X-Microsystems/xmicro-bp8/README.md

# XMICRO-BP8

Eight-slot [XMICRO](https://github.com/x-microsystems/xmicro-bus) backplane.

Datasheet: [XMICRO-BP8](Documentation/XMICRO-BP8.pdf)

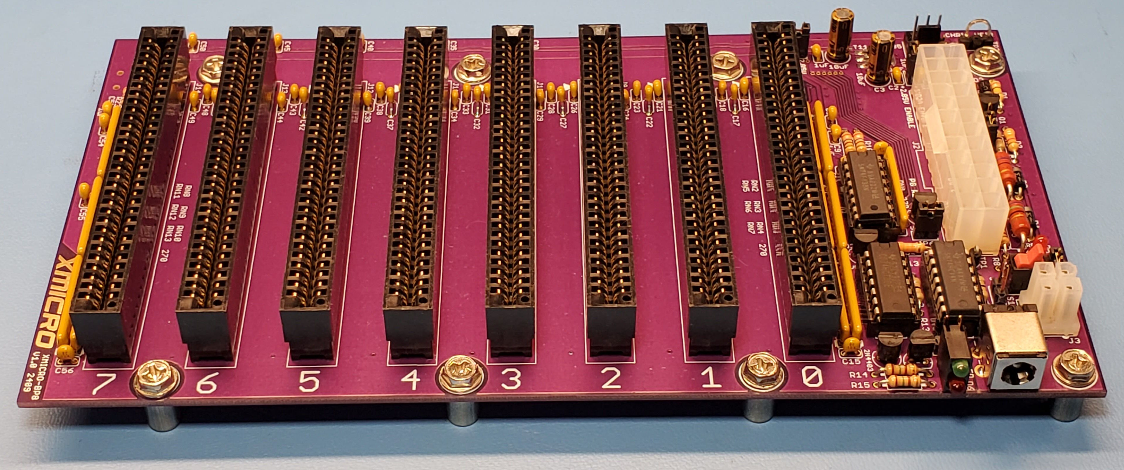
[picture p1: Images/XMICRO-BP8 1.jpg]
XMICRO-BP8
