X-Microsystems/xmicro-bp8/Hardware/Gerbers/README.txt

XMICRO-BP8 is designed for 2oz copper PCBs. Standard 1oz plating will work, but any voltage/current specifications will be invalid and must be derated.
