X-Microsystems/xmicro-bp8/Documentation/Schematics/Netlist.txt

Netlist

Exported from XMICRO-BP8 V1.0.sch at 2024-09-15 12:36:48

EAGLE Version 6.3.0 Copyright (c) 1988-2012 CadSoft

Net      Part     Pad      Pin        Sheet

!BUSAK   J10      12       !BUSAK     1
         J11      12       !BUSAK     1
         J12      12       !BUSAK     1
         J13      12       !BUSAK     1
         J14      12       !BUSAK     1
         J7       12       !BUSAK     1
         J8       12       !BUSAK     1
         J9       12       !BUSAK     1
         RN5      2        2          3
         RN8      2        2          3

!BUSRQ   J10      11       !BUSRQ     1
         J11      11       !BUSRQ     1
         J12      11       !BUSRQ     1
         J13      11       !BUSRQ     1
         J14      11       !BUSRQ     1
         J7       11       !BUSRQ     1
         J8       11       !BUSRQ     1
         J9       11       !BUSRQ     1
         RN11     2        2          3
         RN2      2        2          3

!CS0     J7       9        !CSX       1
         R10      1        1          3
         RN1      3        3          3
         U3       15       Y0         4

!CS1     J8       9        !CSX       1
         R16      1        1          3
         RN1      4        4          3
         U3       14       Y1         4

!CS2     J9       9        !CSX       1
         R17      1        1          3
         RN1      5        5          3
         U3       13       Y2         4

!CS3     J10      9        !CSX       1
         R18      1        1          3
         RN1      6        6          3
         U3       12       Y3         4

!CS4     J11      9        !CSX       1
         R19      1        1          3
         RN1      7        7          3
         U3       11       Y4         4

!CS5     J12      9        !CSX       1
         R20      1        1          3
         RN1      8        8          3
         U3       10       Y5         4

!CS6     J13      9        !CSX       1
         R21      1        1          3
         RN1      9        9          3
         U3       9        Y6         4

!CS7     J14      9        !CSX       1
         R22      1        1          3
         RN1      2        2          3
         U3       7        Y7         4

!FETCH   J10      14       !FETCH     1
         J11      14       !FETCH     1
         J12      14       !FETCH     1
         J13      14       !FETCH     1
         J14      14       !FETCH     1
         J7       14       !FETCH     1
         J8       14       !FETCH     1
         J9       14       !FETCH     1
         RN5      3        3          3
         RN8      3        3          3

!HALT    J10      15       !HALT      1
         J11      15       !HALT      1
         J12      15       !HALT      1
         J13      15       !HALT      1
         J14      15       !HALT      1
         J7       15       !HALT      1
         J8       15       !HALT      1
         J9       15       !HALT      1
         RN11     4        4          3
         RN2      4        4          3

!INH     J10      17       !INH       1
         J11      17       !INH       1
         J12      17       !INH       1
         J13      17       !INH       1
         J14      17       !INH       1
         J7       17       !INH       1
         J8       17       !INH       1
         J9       17       !INH       1
         RN11     5        5          3
         RN2      5        5          3

!IOSEL   J10      18       !IOSEL     1
         J11      18       !IOSEL     1
         J12      18       !IOSEL     1
         J13      18       !IOSEL     1
         J14      18       !IOSEL     1
         J7       18       !IOSEL     1
         J8       18       !IOSEL     1
         J9       18       !IOSEL     1
         RN5      5        5          3
         RN8      5        5          3
         U3       4        G2A        4

!NMI     J10      61       !NMI       1
         J11      61       !NMI       1
         J12      61       !NMI       1
         J13      61       !NMI       1
         J14      61       !NMI       1
         J7       61       !NMI       1
         J8       61       !NMI       1
         J9       61       !NMI       1
         RN13     2        2          3
         RN4      2        2          3

!RD      J10      19       !RD        1
         J11      19       !RD        1
         J12      19       !RD        1
         J13      19       !RD        1
         J14      19       !RD        1
         J7       19       !RD        1
         J8       19       !RD        1
         J9       19       !RD        1
         RN11     6        6          3
         RN2      6        6          3

!RST     J10      10       !RST       1
         J11      10       !RST       1
         J12      10       !RST       1
         J13      10       !RST       1
         J14      10       !RST       1
         J7       10       !RST       1
         J8       10       !RST       1
         J9       10       !RST       1
         JP6      2        2          2
         R11      2        2          3
         R12      1        1          2
         R23      2        2          3

!SINT    J10      51       !SINT      1
         J11      51       !SINT      1
         J12      51       !SINT      1
         J13      51       !SINT      1
         J14      51       !SINT      1
         J7       51       !SINT      1
         J8       51       !SINT      1
         J9       51       !SINT      1
         Q3       3        D          4
         RN10     6        6          3
         RN7      6        6          3

!V0      J10      53       !V0        1
         J11      53       !V0        1
         J12      53       !V0        1
         J13      53       !V0        1
         J14      53       !V0        1
         J7       52       !IRQX      1
         J7       53       !V0        1
         J8       53       !V0        1
         J9       53       !V0        1
         RN13     6        6          3
         RN4      6        6          3
         U4       1        I0         4

!V1      J10      54       !V1        1
         J11      54       !V1        1
         J12      54       !V1        1
         J13      54       !V1        1
         J14      54       !V1        1
         J7       54       !V1        1
         J8       52       !IRQX      1
         J8       54       !V1        1
         J9       54       !V1        1
         RN10     5        5          3
         RN7      5        5          3
         U4       2        I1         4

!V2      J10      55       !V2        1
         J11      55       !V2        1
         J12      55       !V2        1
         J13      55       !V2        1
         J14      55       !V2        1
         J7       55       !V2        1
         J8       55       !V2        1
         J9       52       !IRQX      1
         J9       55       !V2        1
         RN13     5        5          3
         RN4      5        5          3
         U4       3        I2         4

!V3      J10      52       !IRQX      1
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
         RN3      1        1          3
         RN4      1        1          3
         RN5      1        1          3
         RN6      1        1          3
         RN7      1        1          3
         RN8      1        1          3
         RN9      1        1          3
