X-Microsystems/xmicro-bp8/Documentation/XMICRO-BP8.odt

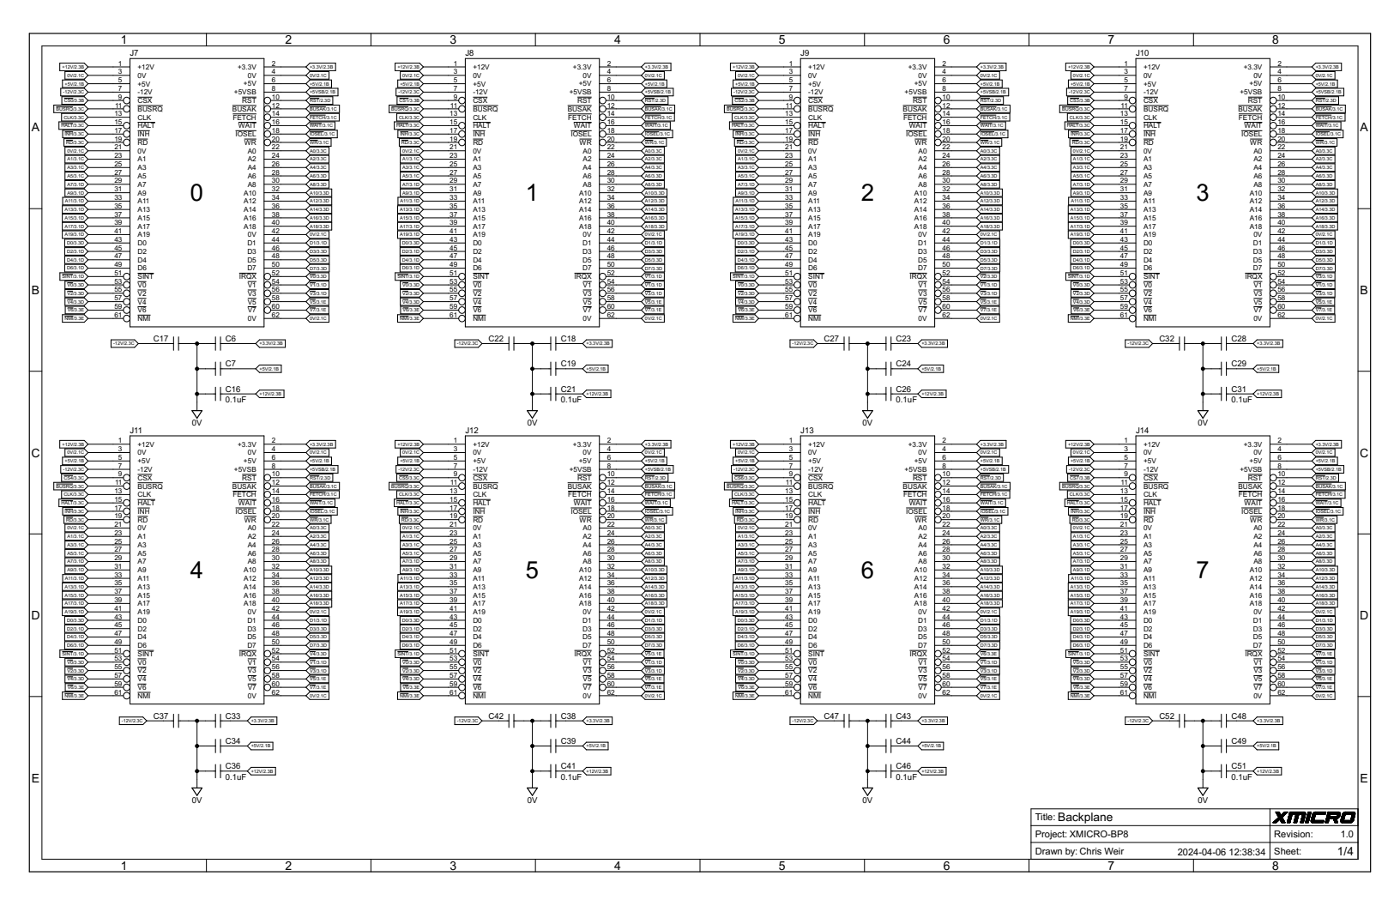
[picture p2: figure]
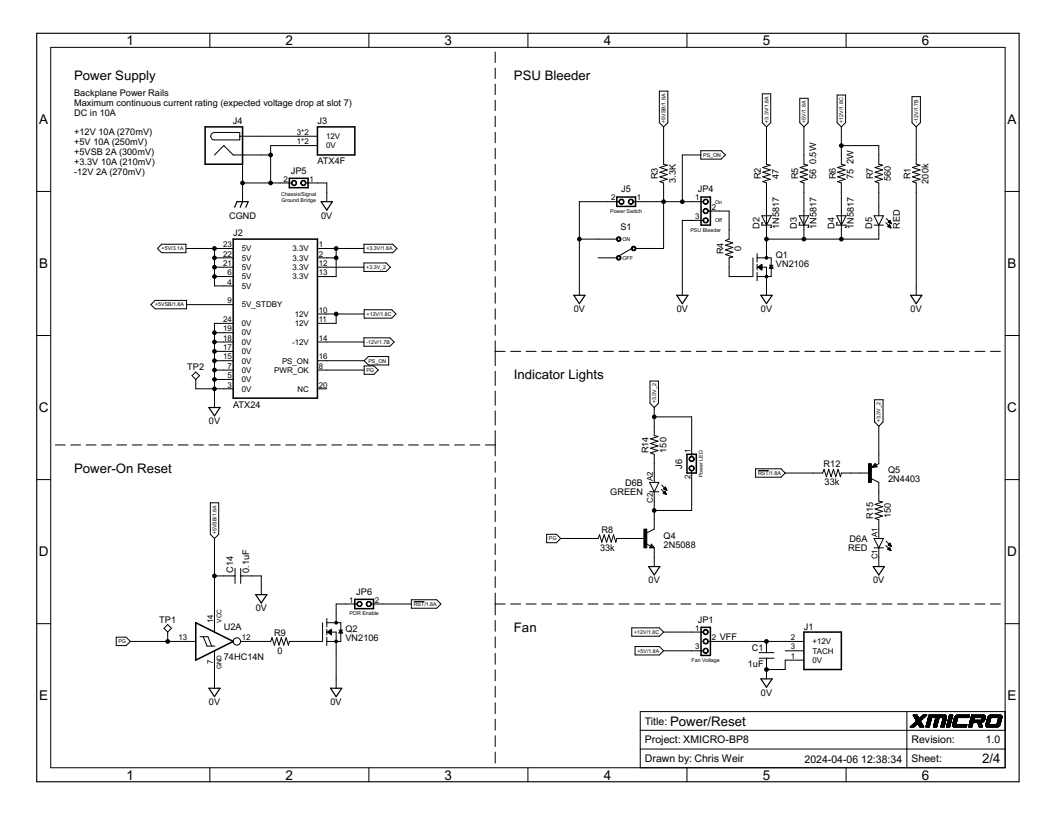
[picture p3: figure]
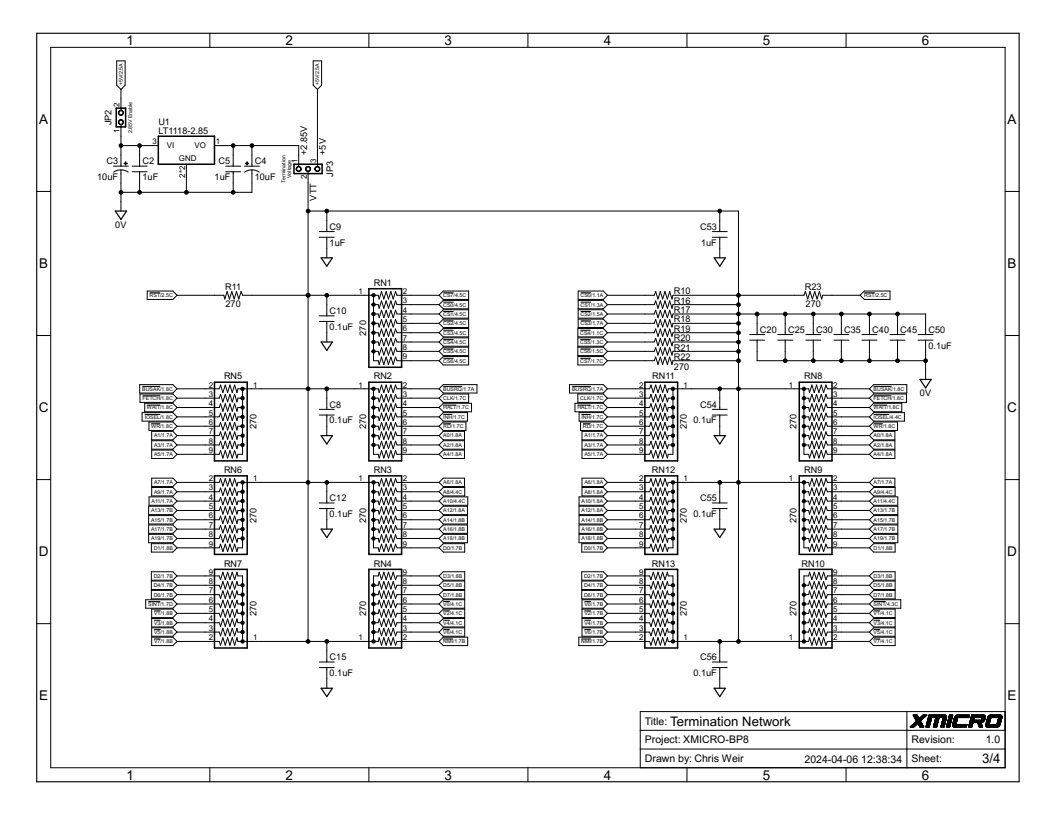
[picture p4: figure]
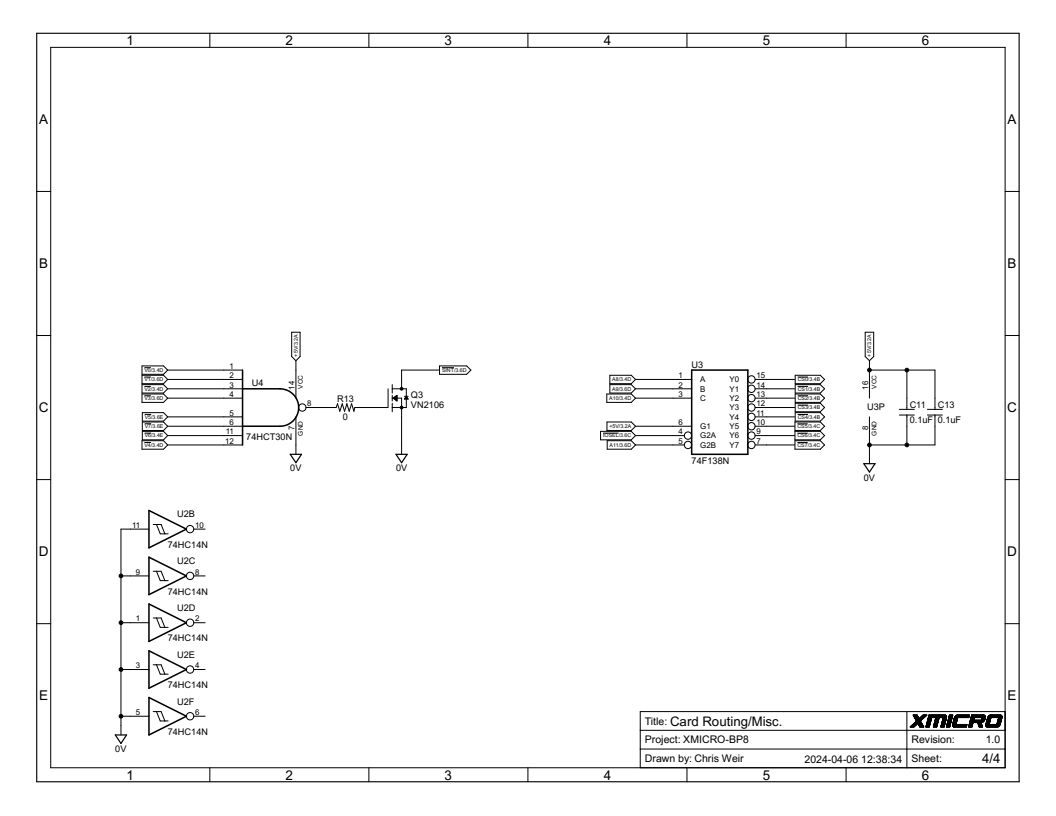
[picture p5: figure]

# General Description

The XMICRO-BP8 is an eight-slot XMICRO backplane with an ATX-compatible power input.

## Features

- 8 card slots
- Compatible with standard ATX power supplies
- DC power input for Pico ATX power supplies
- Active signal termination

## System Outline

Table 1: DC Specifications

Rail | Max. Current Total | Max. Current per card | Max. Current Per Contact | Slot 7 Voltage Drop @ Max. I
+12V | 10.0 A | 2.0 A | 2.0 A | 270 mV
+5V | 10.0 A | 4.0 A | 2.0 A | 250 mV
+5VSB | 2.0 A | 1.0 A | 1.0 A | 300 mV
+3.3V | 10.0 A | 2.0 A | 2.0 A | 210 mV
-12V | 2.0 A | 1.0 A | 1.0 A | 270 mV
DC IN | 10.0 A | - | - | -
*All current ratings continuous

Table 2: Backplane Configuration

Setting | Function
JP1 | Fan voltage select
JP2 | +2.85V termination regulator enable
JP3 | Bus termination voltage select
JP4 | PSU power-off bleeder enable/disable
JP5 | Bridge chassis/signal ground
JP6 | Power-on reset enable

# Power Supply

## PSU Selection

The backplane accepts standard ATX power supplies. Because of the relatively low power requirements of XMICRO systems, virtually any PC power supply will have suitable power delivery specifications.

The XMICRO-BP8 was designed to accept “Pico” style PSU-on-connector modules. A center-positive barrel jack (J4) is provided at the rear of the board to supply these modules with DC input power. This input is routed to a 4-pin Molex Mini-Fit Jr. connector (J3) with the standard ATX CPU pinout.

The PicoPSU-160-XT is recommended and directly compatible with the DC input jack.

## Grounding

When the DC input jack is not used, such as with full-sized ATX power supplies, jumper JP5 should be shorted. This connects the system chassis to the PSU ground to provide a return path for stray ESD/EMF.

## PSU Bleeder

During development, some PSUs, particularly Pico-style PSUs, were found to have excessive power-down times if certain rails are unloaded. A PSU bleeder circuit was added to the backplane to drain residual charge from the power rails, and to make the power-down faster and more stable.

The operation of this circuit is selected by jumper JP4, which must be set to ensure proper operation. For most ATX supplies, JP4 may be set to the OFF position. If power-down time is found to be excessive, JP4 may be set to the ON position, provided the power-down time is improved. This can be roughly visibly gauged by the Reset indicator fading slowly during power-down.

LED D5 indicates that the bleeder is active. It should only flash briefly when the power is switched off. If D5 is illuminated while the system is powered on, this indicates a fault in the circuit and JP4 should be confirmed. While the bleeder was designed to be capable of continuous operation in case of faults, it will generate excessive heat and should not be allowed to operate in this way.

# Signal Termination

The XMICRO-BP8 contains a termination network for all bus signal lines. This pulls all signals to +2.85V through a 270Ω resistor at each end of the backplane. This pulls signal lines to a known high state when not driven, and reduces ringing on fast signal edges. The termination network provides a significant load on signals, and as such cards must have drivers capable of sourcing/sinking at least 20mA per signal when it is fitted.

The termination network was designed with some flexibility for experimentation and troubleshooting, however in typical operation JP2 should be closed and JP3 should be set to “2.85V”.

# Off-board Components

## Power Switch

The backplane is fitted with an onboard power switch (S1) for development or operation without a chassis. An external power switch may be connected at header J5. When an external switch is used, S1 must be set in the OFF position.

## Power Indicator

A power indicator LED is provided on the rear of the backplane. An additional header (J6) is available for an external LED if desired. This connector provides a low-impedance 3.3V when the system power is on, so an appropriate current-limiting resistor should be fitted to any LED connected to it.

## Fan

A fan header (J1) is available for optional active cooling. Jumper JP1 selects a fan voltage and may be set to +5V for low noise, or +12V for full speed. An external fan controller may also be used on +12V.
