X-Microsystems/xmicro-bp8/Images/XMICRO-BP8 2.jpg

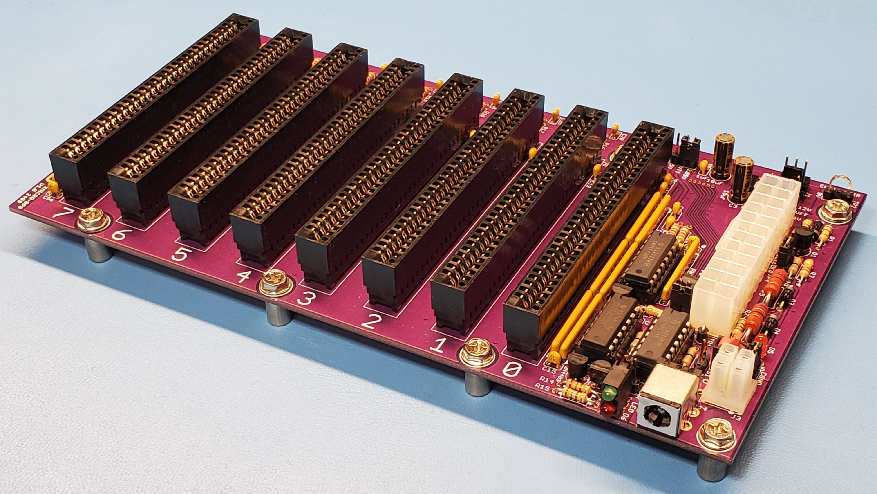
Images/XMICRO-BP8 2.jpg
