X-Microsystems/xmicro-bp8/Documentation/Schematics/XMICRO-BP8 V1.0 Color.pdf

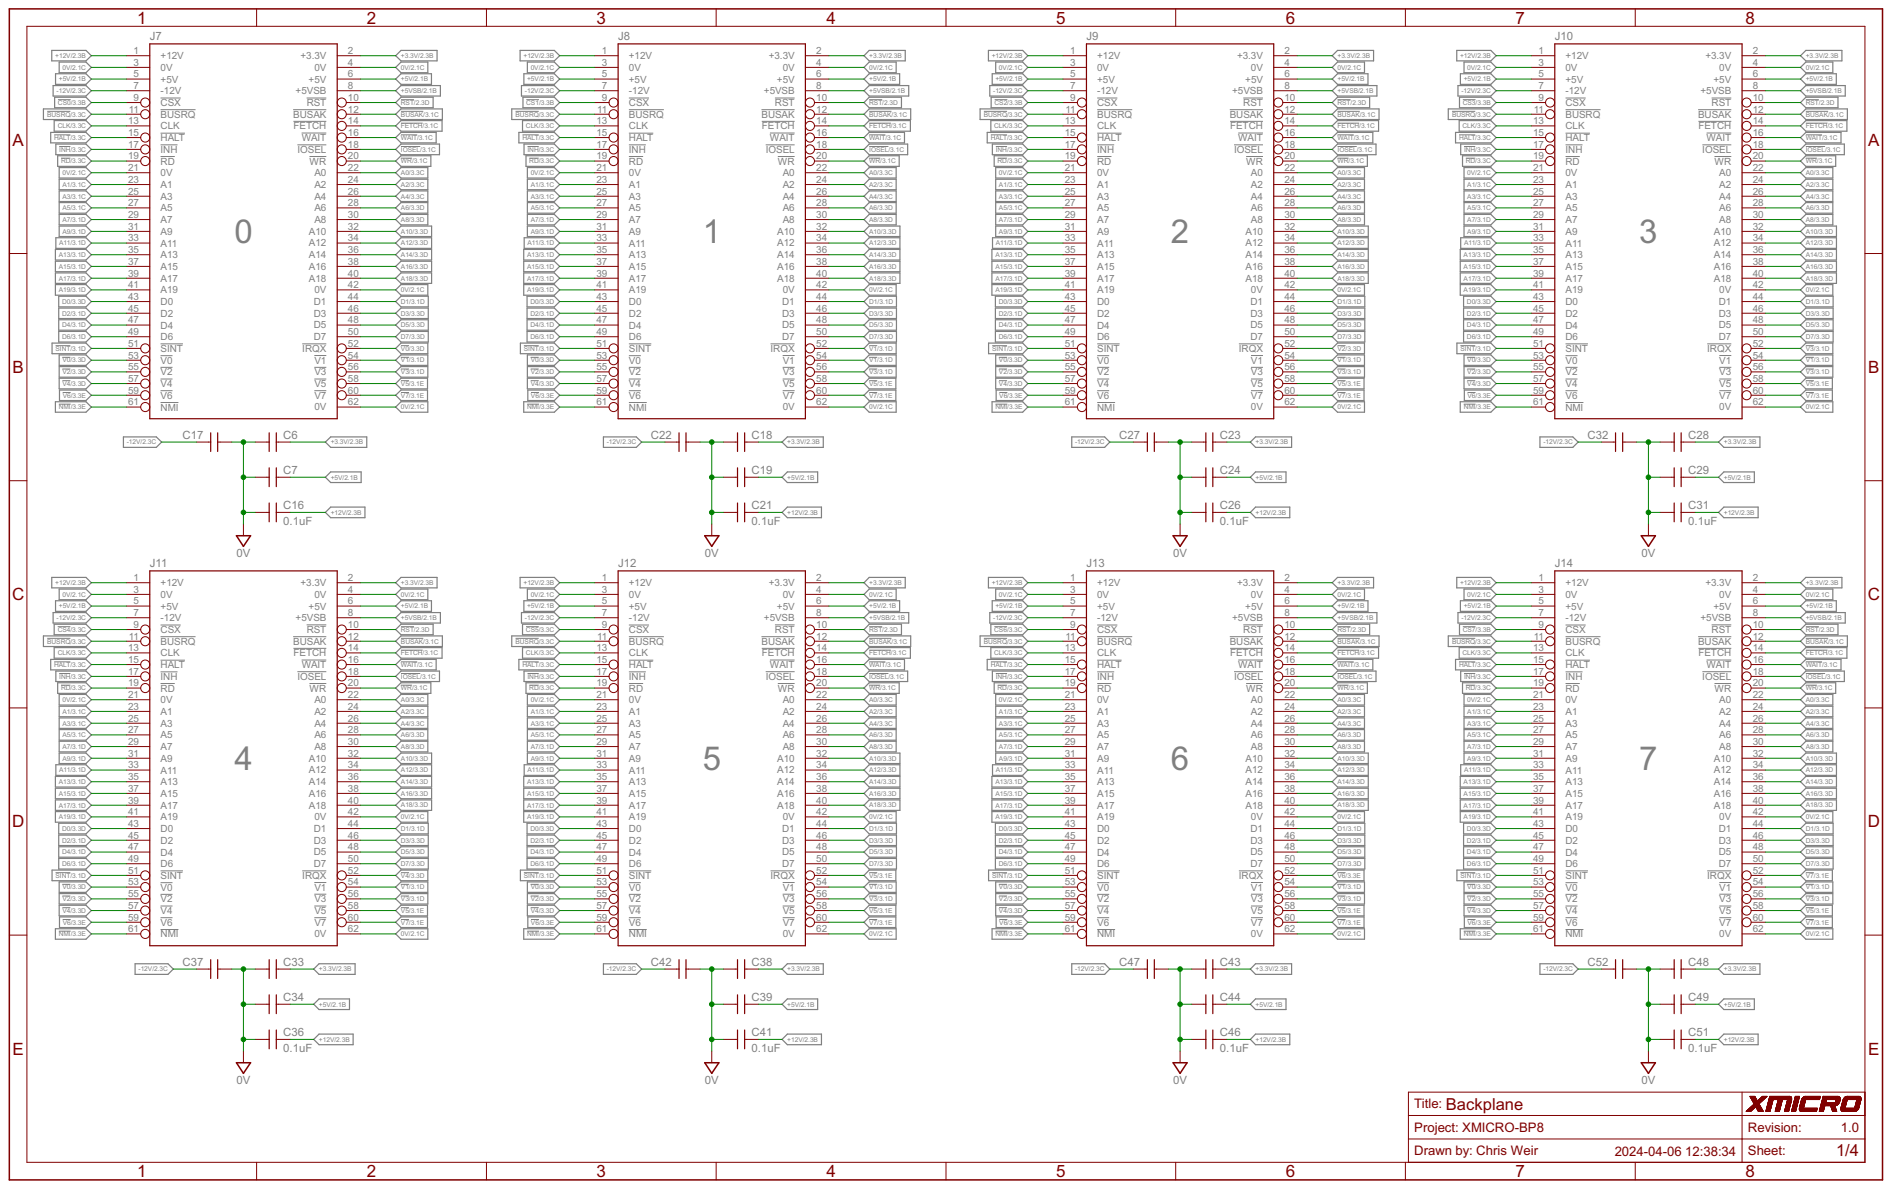
[picture p11: page 1]

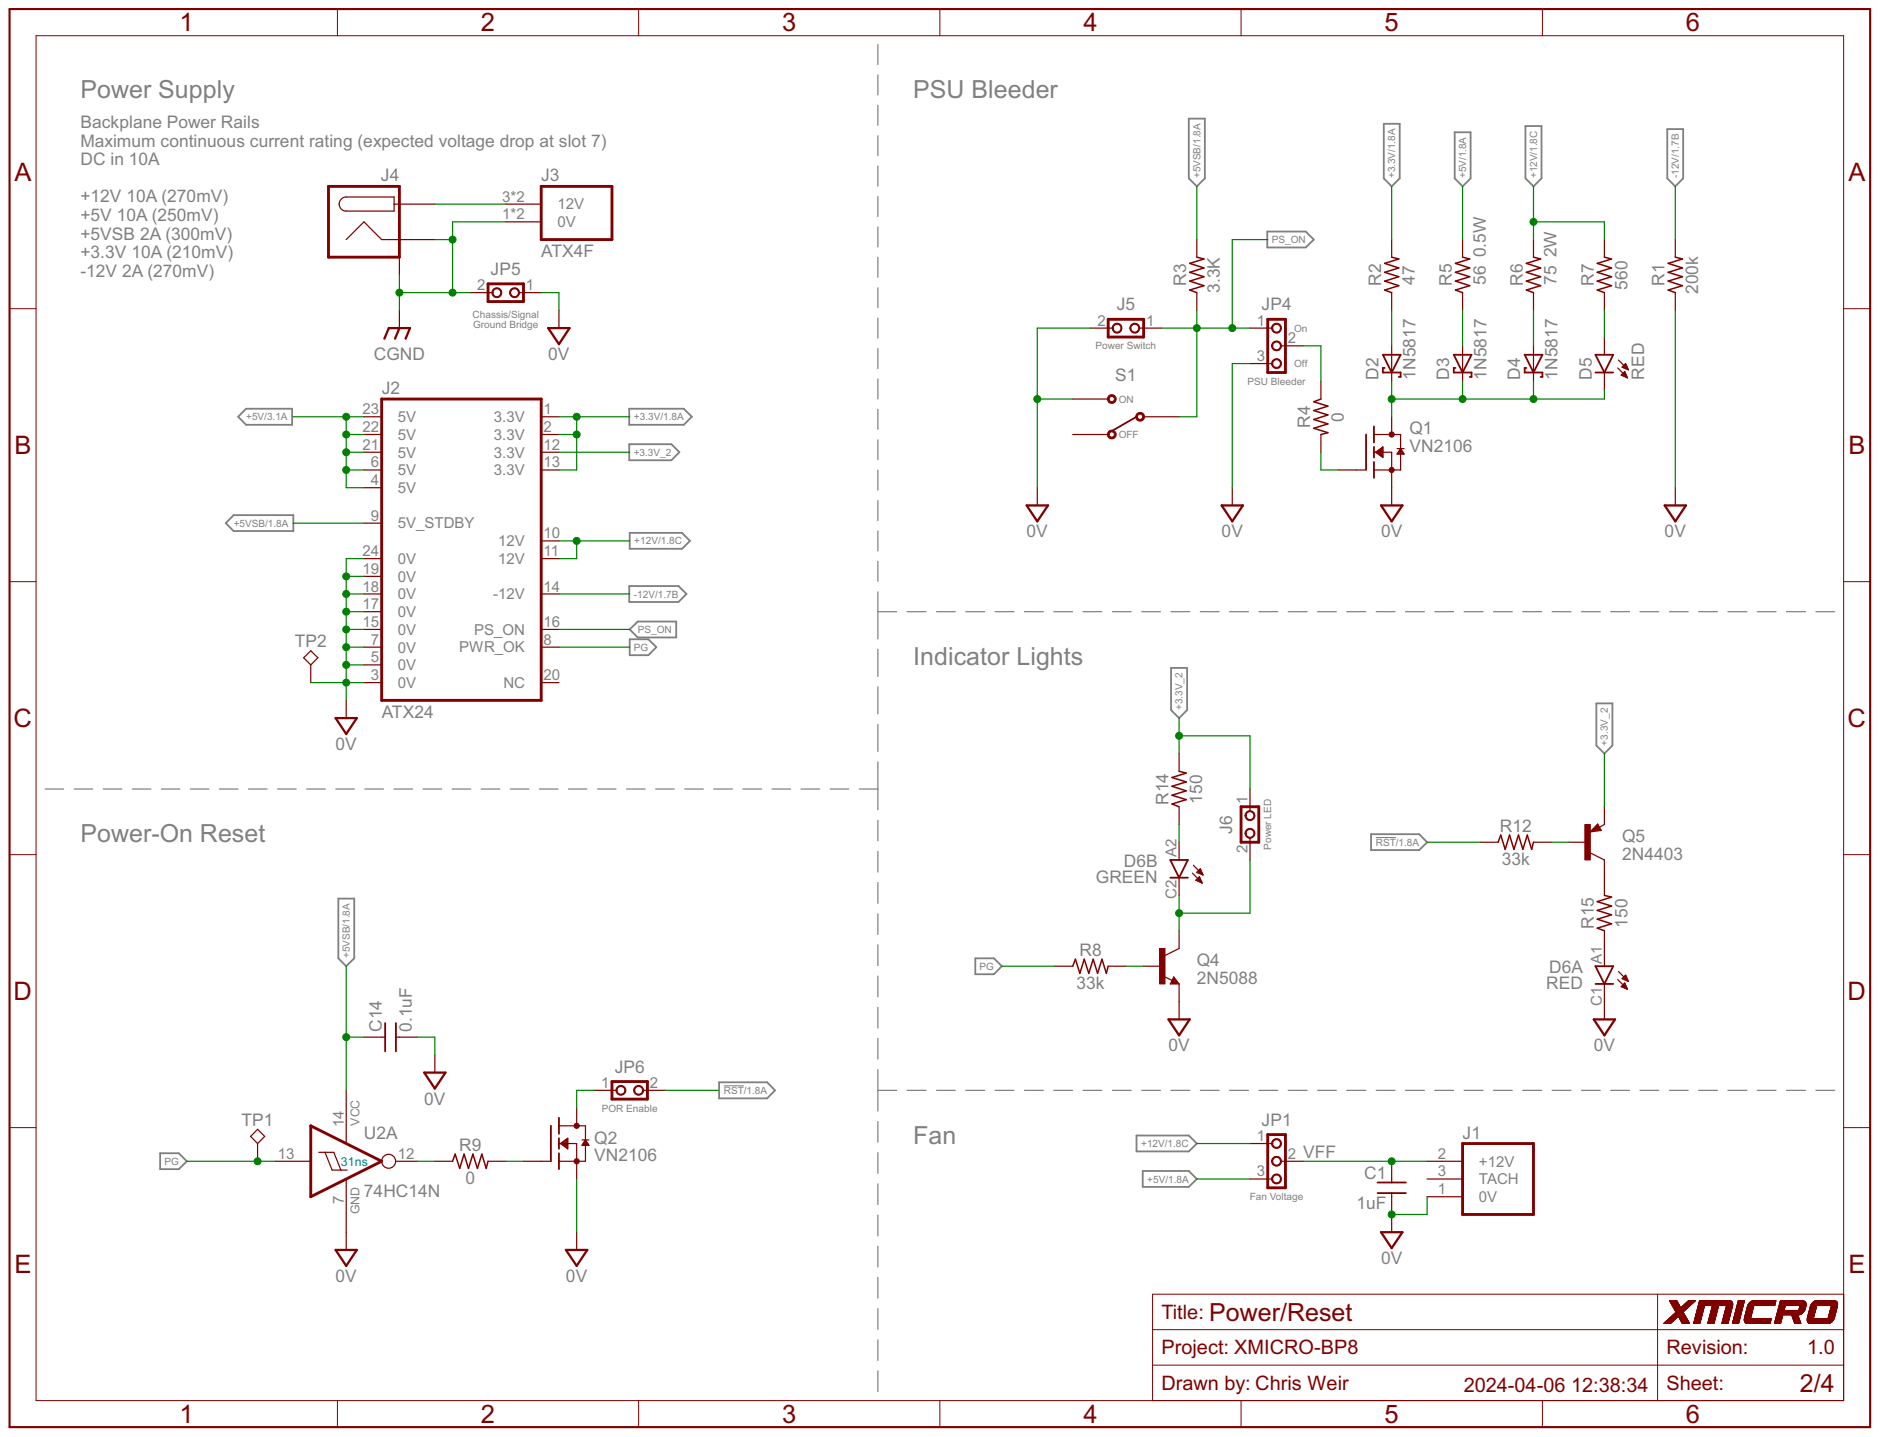
[picture p12: page 2]

Backplane Power Rails Maximum continuous current rating (expected voltage drop at slot 7)

22 | 2
21 | 12
6 | 13

Title: Project: Drawn by: Power/Reset XMICRO-BP8 | Revision: Chris Weir Sheet: 2/4 1.0

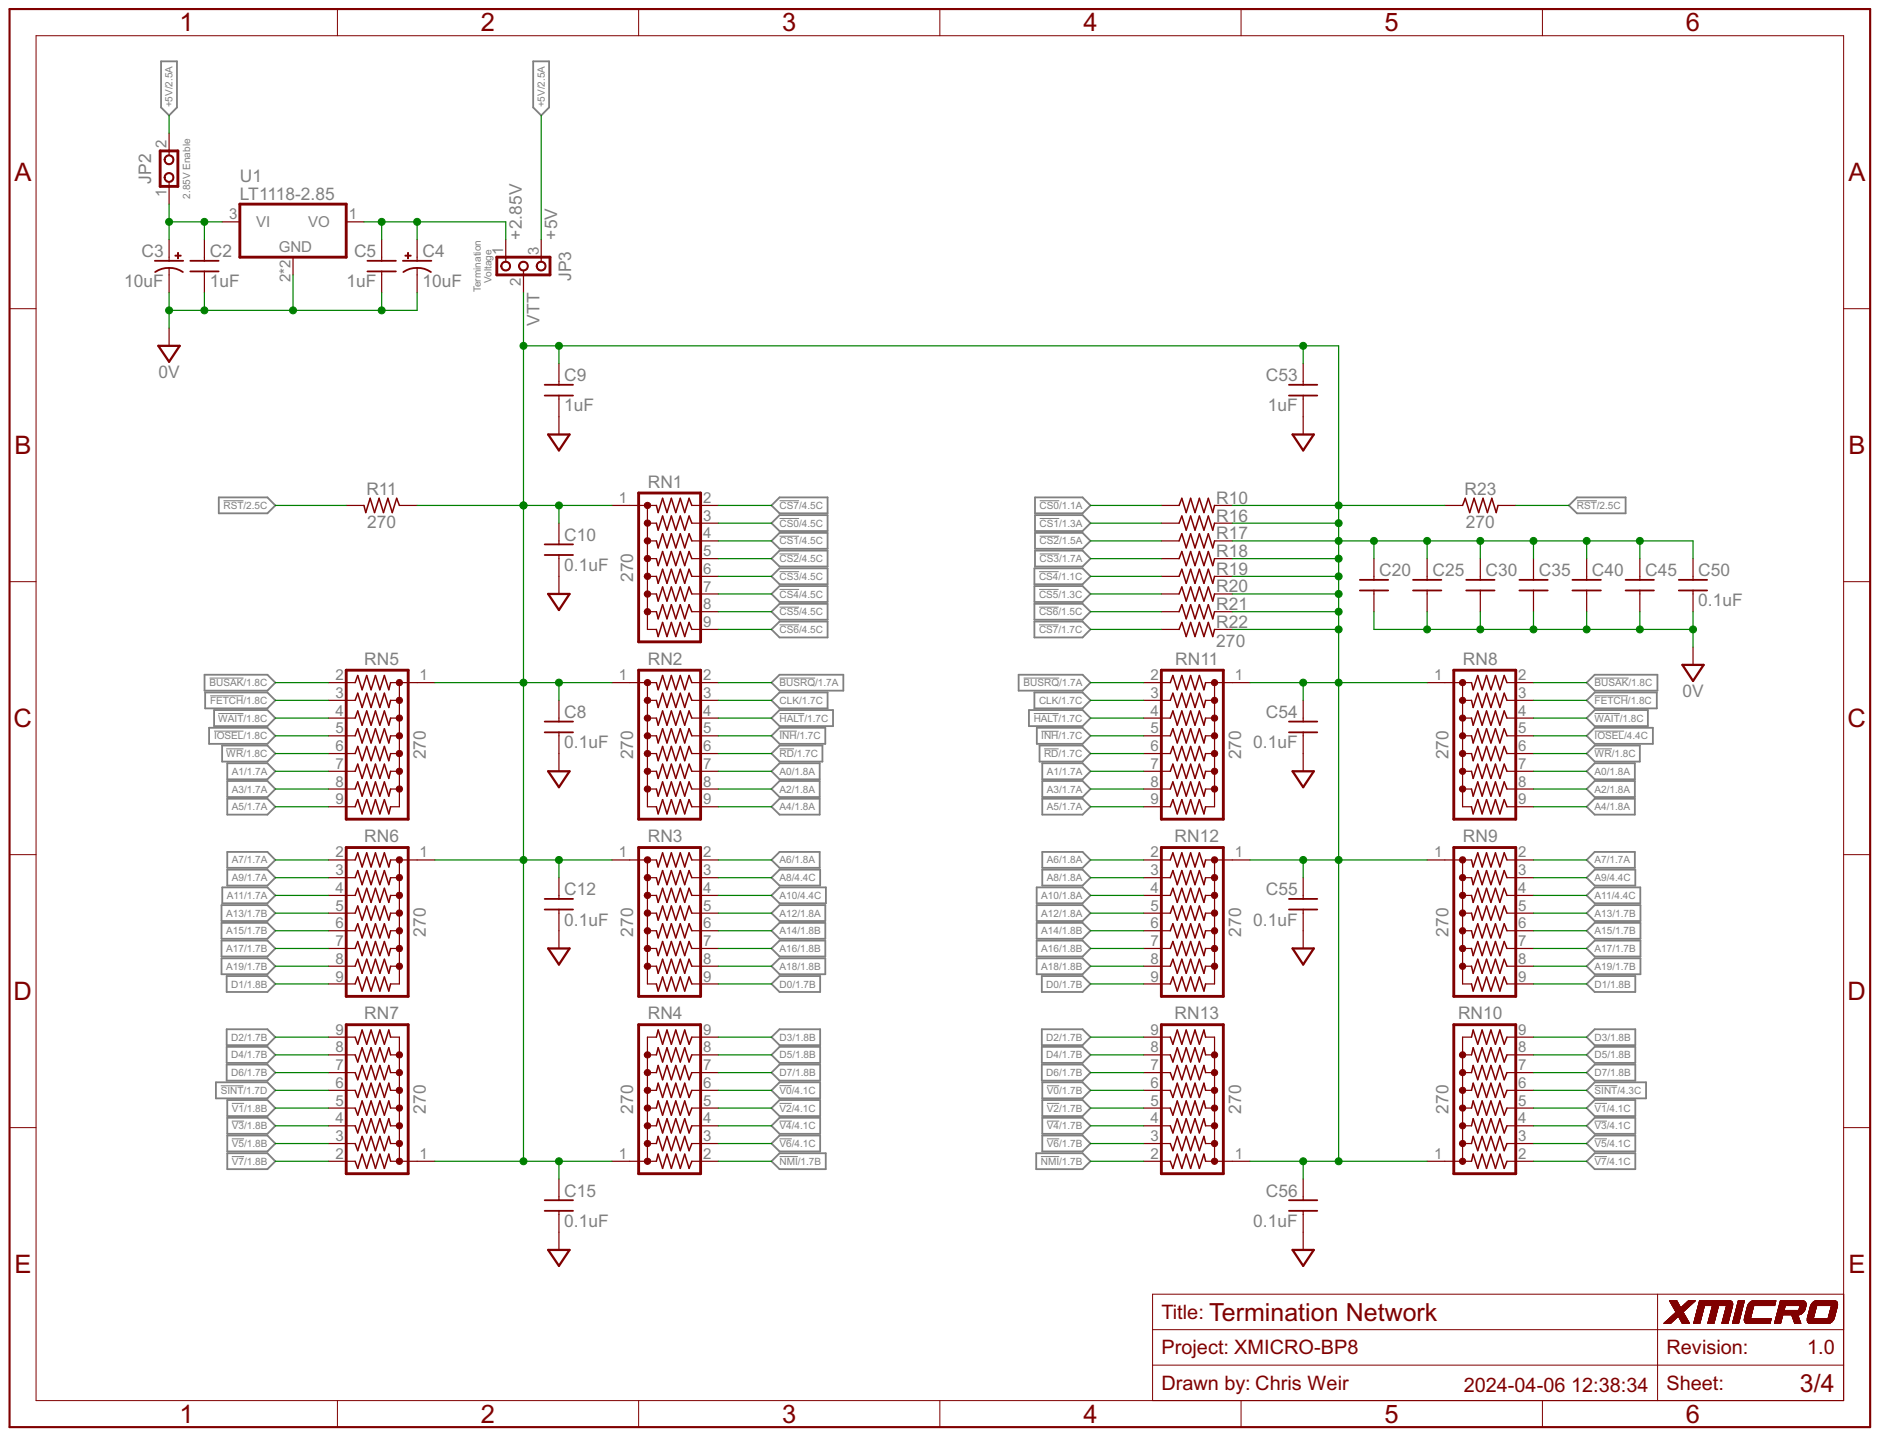
[picture p13: page 3]

Termination Voltage 2.85V Enable 10uF 1uF 1uF 270 270 270 270 270 270 270 270 270 270 270 2700.1uF 0.1uF 0.1uF 0.1uF 0.1uF 0.1uF 270 270 270 270 0.1uF 0.1uF 0V 10uF LT1118-2.85 1uF 1uF 0V C3 C5 JP2 1 2 C2 2 1 3456789 RN6 1 23456789 RN3 2 1 3456789 RN7 1 23456789 RN4 1 23456789 RN2 2 1 3456789 RN5 2 1 3456789 RN12 1 23456789 RN9 2 1 3456789 RN13 1 23456789 RN10 1 23456789 RN8 2 1 3456789 RN11 C54 C55 C56 C12 C8C15 1 2 3 JP3 R11 R23 1 23456789 RN1 R10 R16 R17 R18 R19 R20 R21 R22 C20 C25 C30 C35 C40 C45 C50 C10 C4 U1 GND VI 3 2*2 VO 1 C9 C53 A15/1.7B A14/1.8B A14/1.8B A15/1.7B A13/1.7B A12/1.8A A12/1.8A A13/1.7B A11/1.7A A10/4.4C A10/1.8A A11/4.4C A9/1.7A A8/4.4C A8/1.8A A9/4.4C NMI/1.7B NMI/1.7B BUSAK/1.8C BUSAK/1.8C RST/2.5C RST/2.5C V0/4.1C V0/1.7B V1/1.8B V2/4.1C V2/1.7B V1/4.1C V3/1.8B V4/4.1C V4/1.7B V3/4.1C V5/1.8B V6/4.1C V6/1.7B V5/4.1C V7/1.8B V7/4.1C A17/1.7B A16/1.8B A16/1.8B A17/1.7B A19/1.7B A18/1.8B A18/1.8B A19/1.7B SINT/1.7D SINT/4.3C WAIT/1.8C WAIT/1.8C D1/1.8B D0/1.7B D0/1.7B D1/1.8B WR/1.8C RD/1.7C RD/1.7C WR/1.8C IOSEL/1.8C IOSEL/4.4C HALT/1.7C HALT/1.7C CLK/1.7C CLK/1.7C BUSRQ/1.7A BUSRQ/1.7A A1/1.7A A0/1.8A A1/1.7A A0/1.8A A3/1.7A A2/1.8A A3/1.7A A2/1.8A A5/1.7A A4/1.8A A5/1.7A A4/1.8A A7/1.7A A6/1.8A A6/1.8A A7/1.7A D2/1.7B D3/1.8B D2/1.7B D3/1.8B D4/1.7B D5/1.8B D4/1.7B D5/1.8B D6/1.7B D7/1.8B D6/1.7B D7/1.8B INH/1.7C INH/1.7C FETCH/1.8C FETCH/1.8C +2.85V CS0/4.5C CS7/4.5C CS0/1.1A CS6/4.5C CS7/1.7C CS5/4.5C CS6/1.5C CS4/4.5C CS5/1.3C CS3/4.5C CS4/1.1C CS2/4.5C CS3/1.7A CS1/4.5C CS2/1.5A CS1/1.3A VTT +5V +5V/2.5A +5V/2.5A ABCDE 1 2 3 4 5 6 ABCDE 1 2 3 4 5 6 Title: Project: Revision: Chris Weir Sheet: 3/4 XMICRO-BP8 2024-04-06 12:38:34 1.0 Drawn by: Termination Network

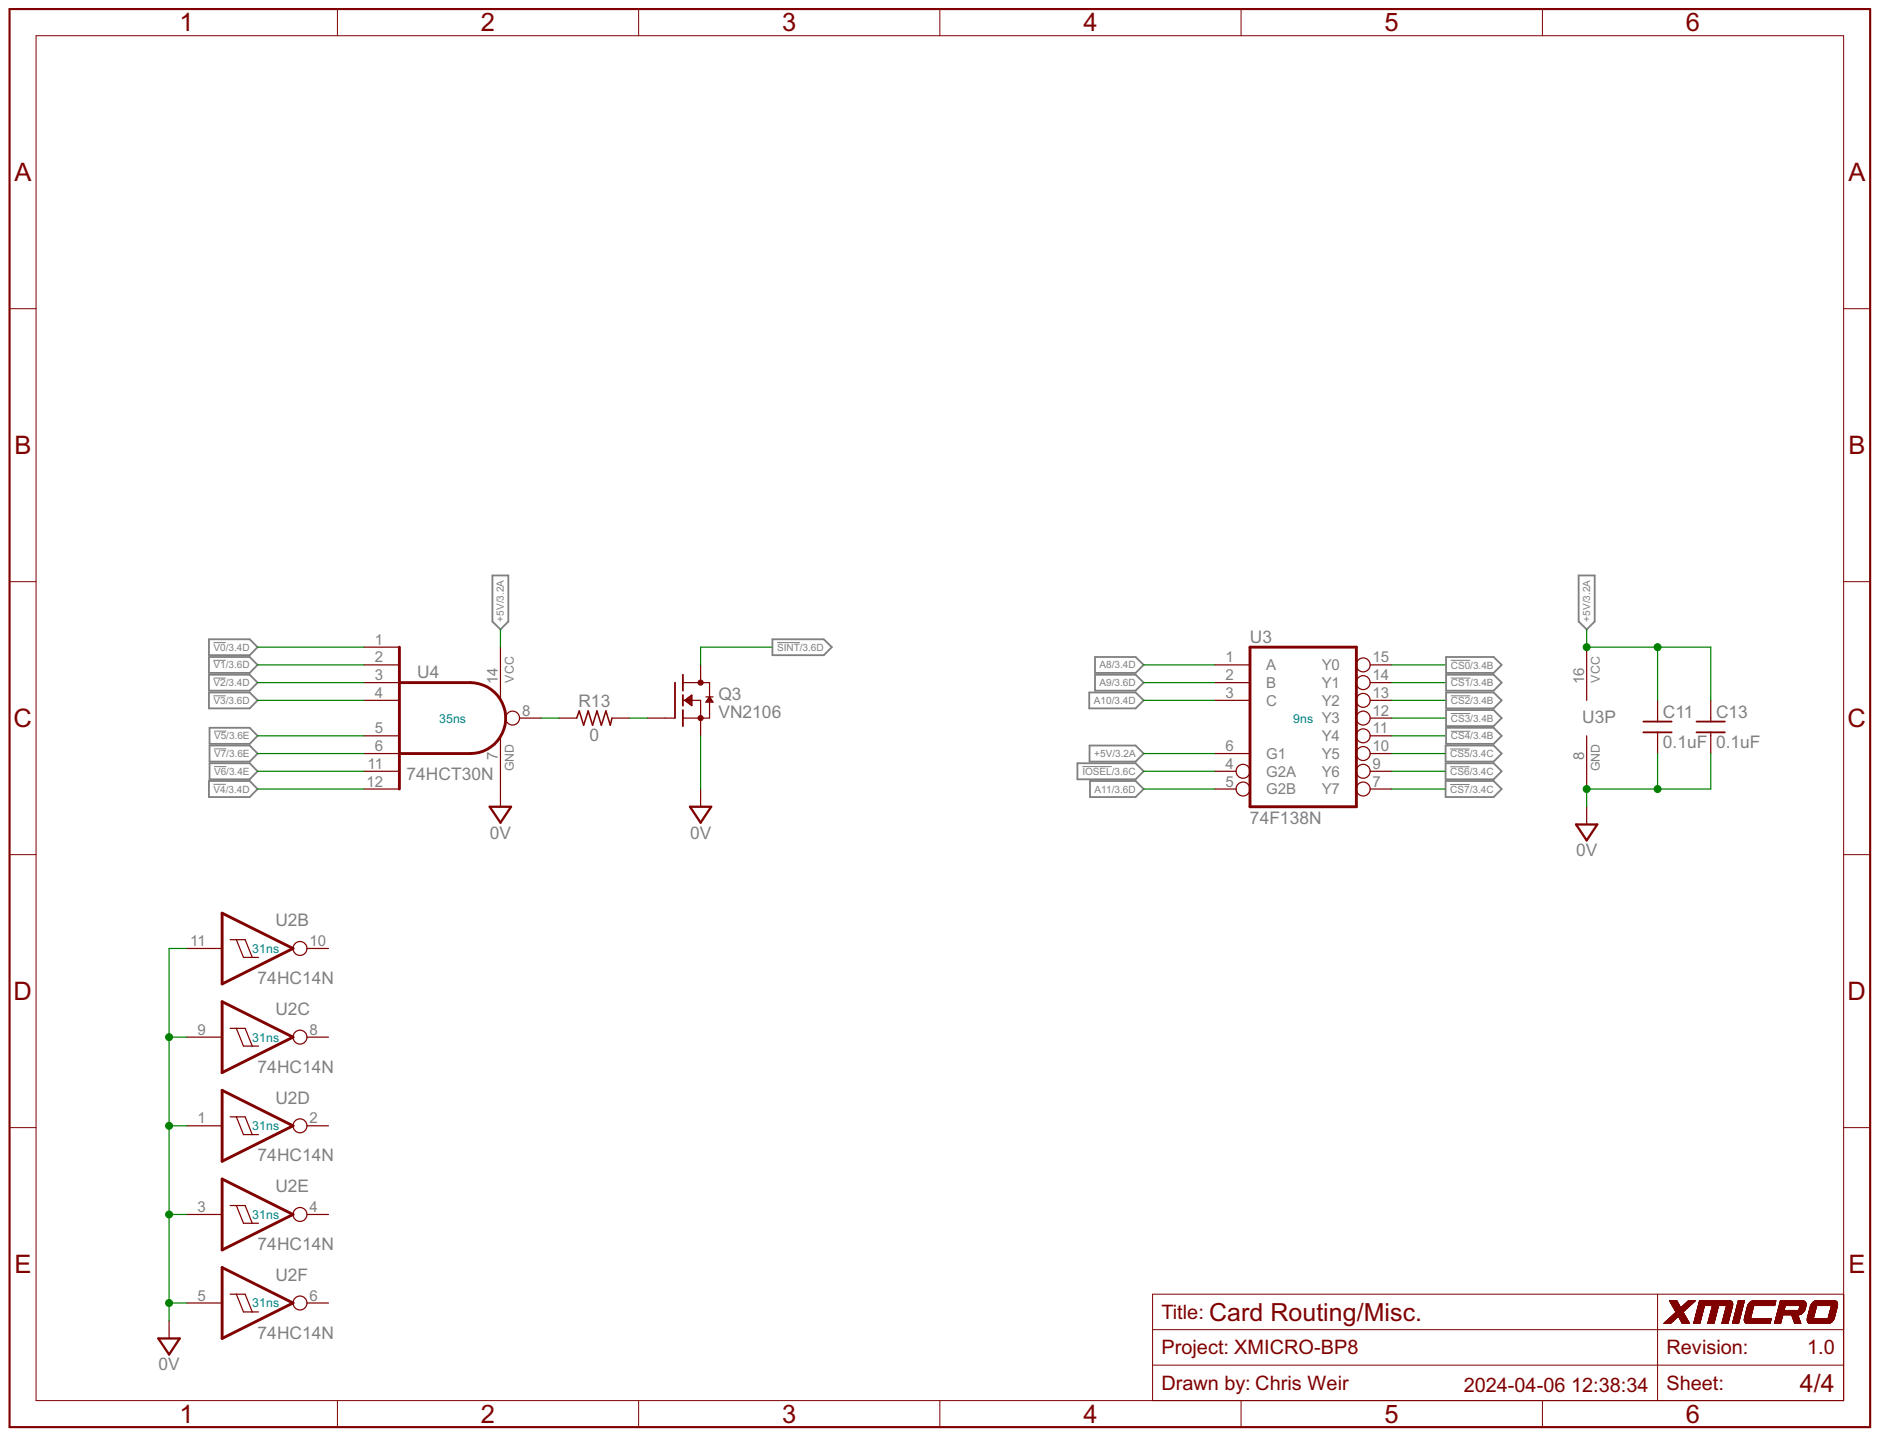
[picture p14: page 4]

Title: Project: Drawn by: Card Routing/Misc. XMICRO-BP8 | Revision: Chris Weir Sheet: 4/4 1.0
