X-Microsystems/xmicro-bp8/Documentation/Schematics/XMICRO-BP8 V1.0 Black Large.pdf

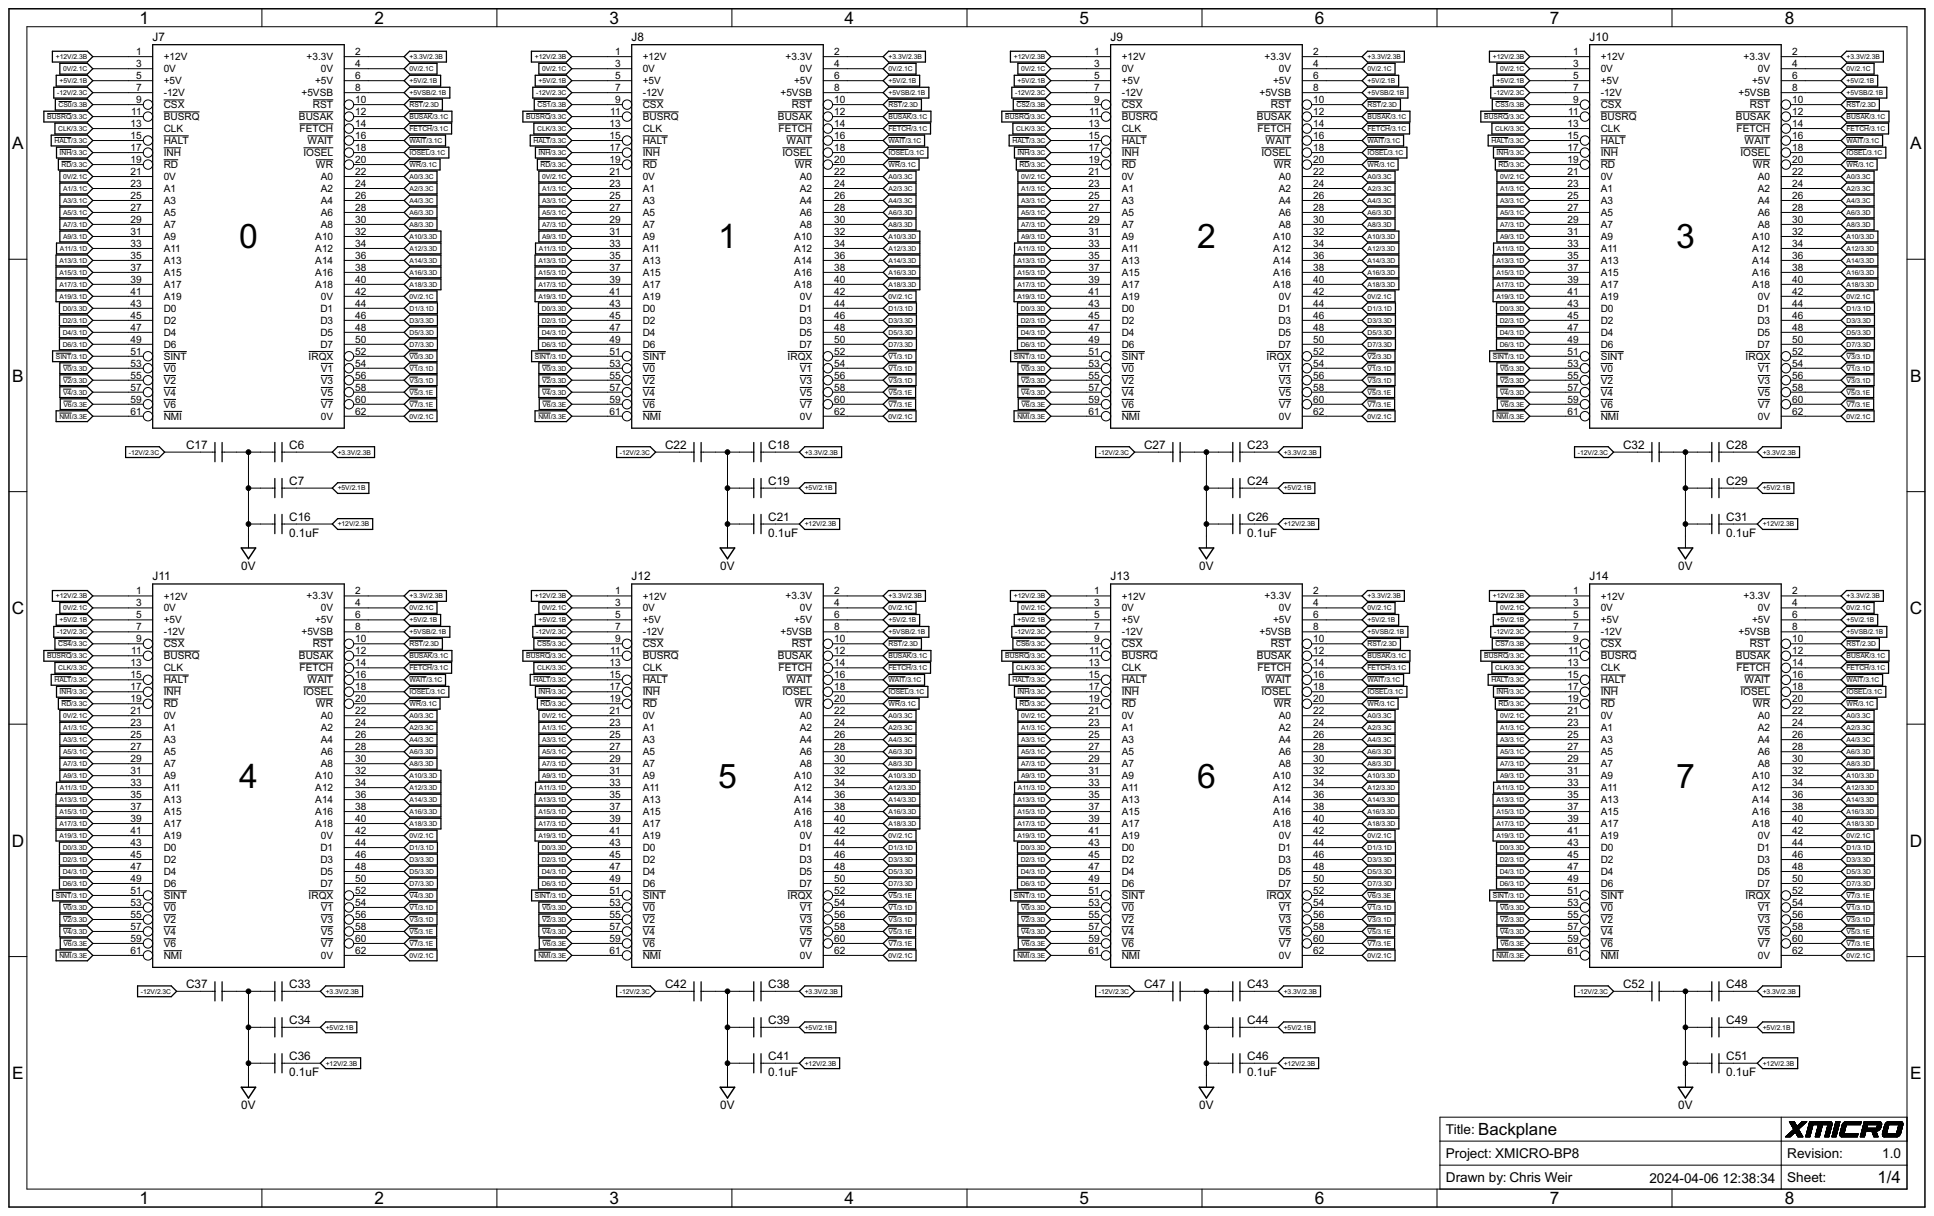
[picture p15: page 1]
