X-Microsystems/xmicro-bp8/Documentation/Schematics/XMICRO-BP8 V1.0 Color Large.pdf

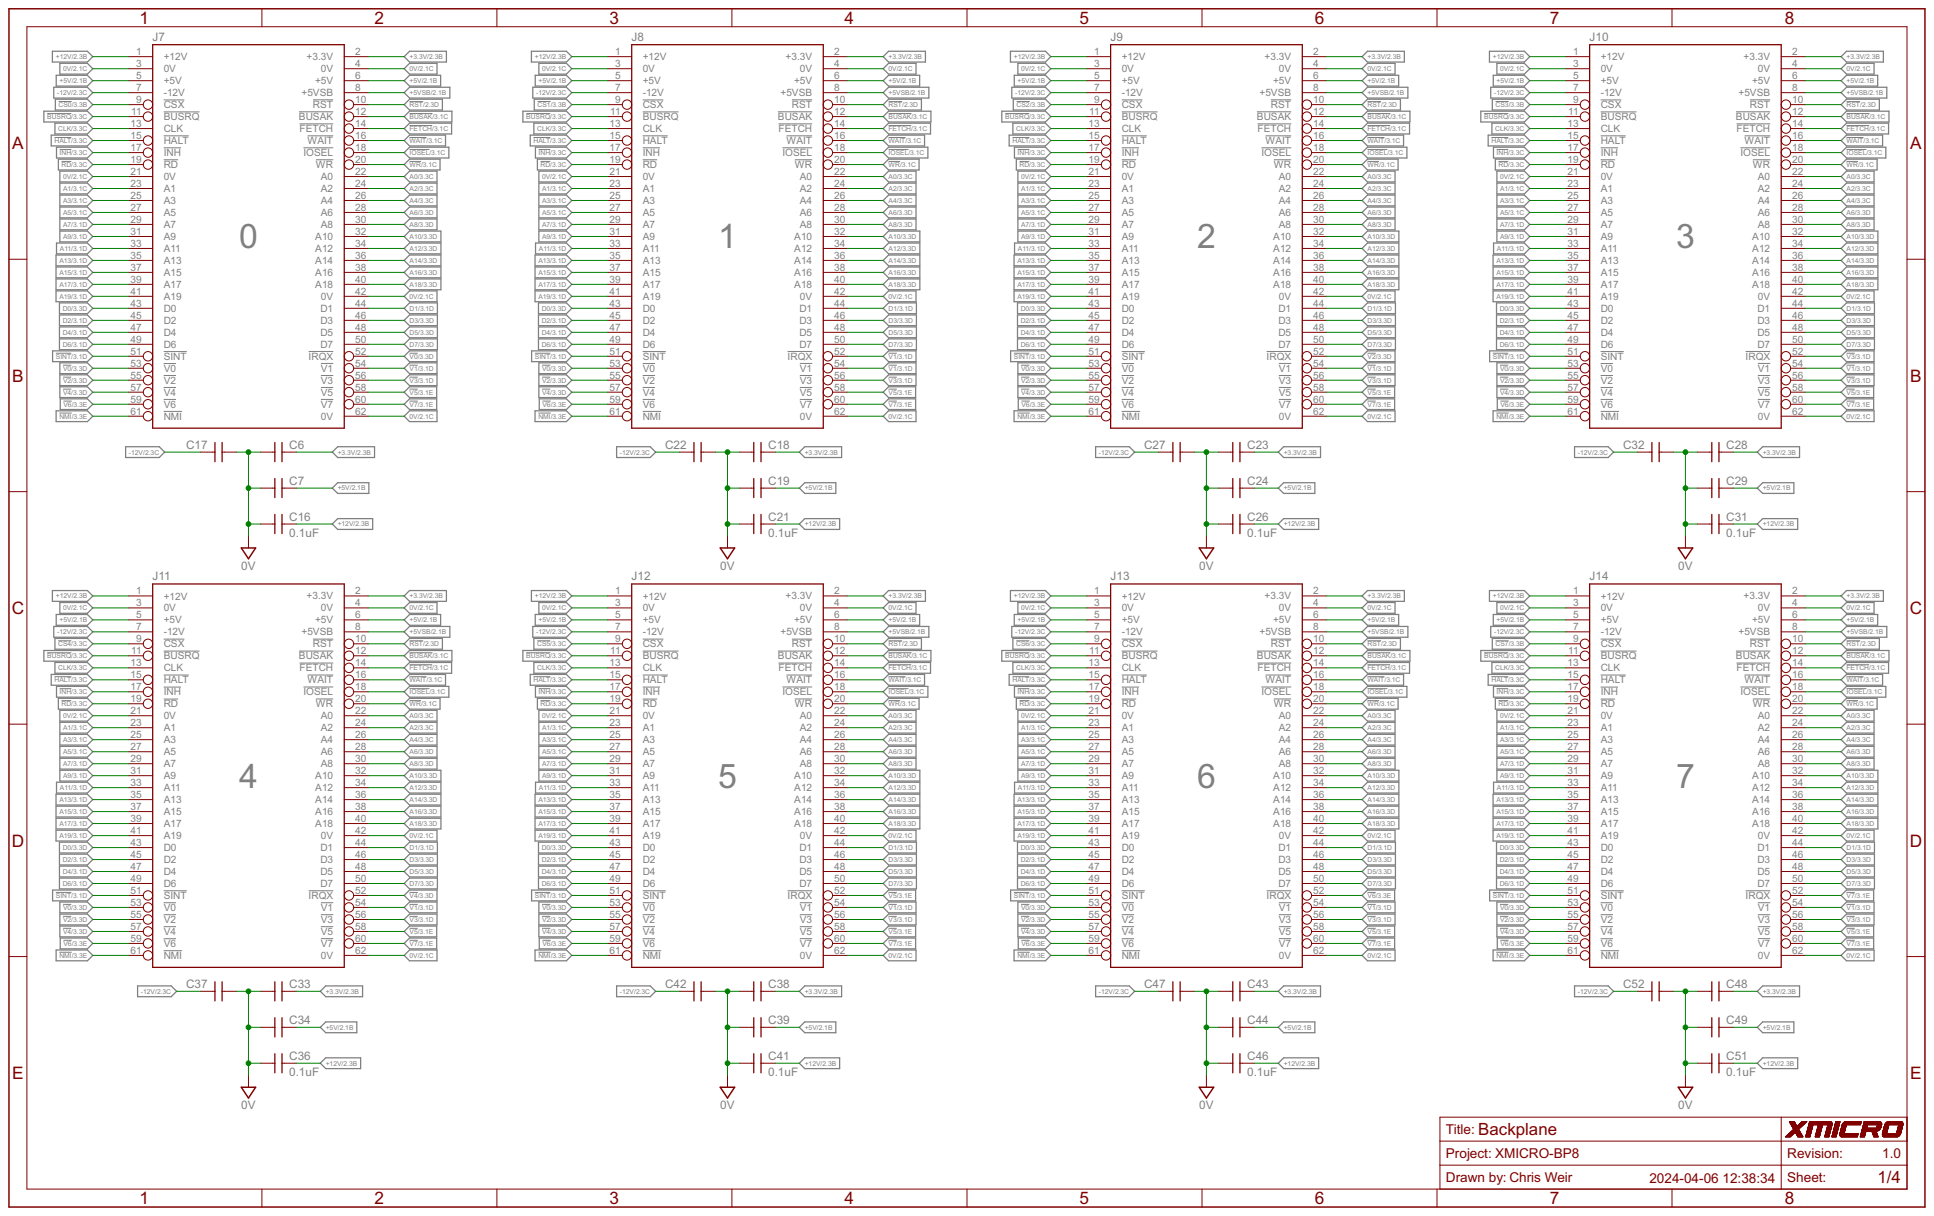
[picture p16: page 1]
