X-Microsystems/xmicro-bp8/CAD/V1.1/XMICRO-BP8.sch

## EAGLE design CAD/V1.1/XMICRO-BP8.sch (continued)

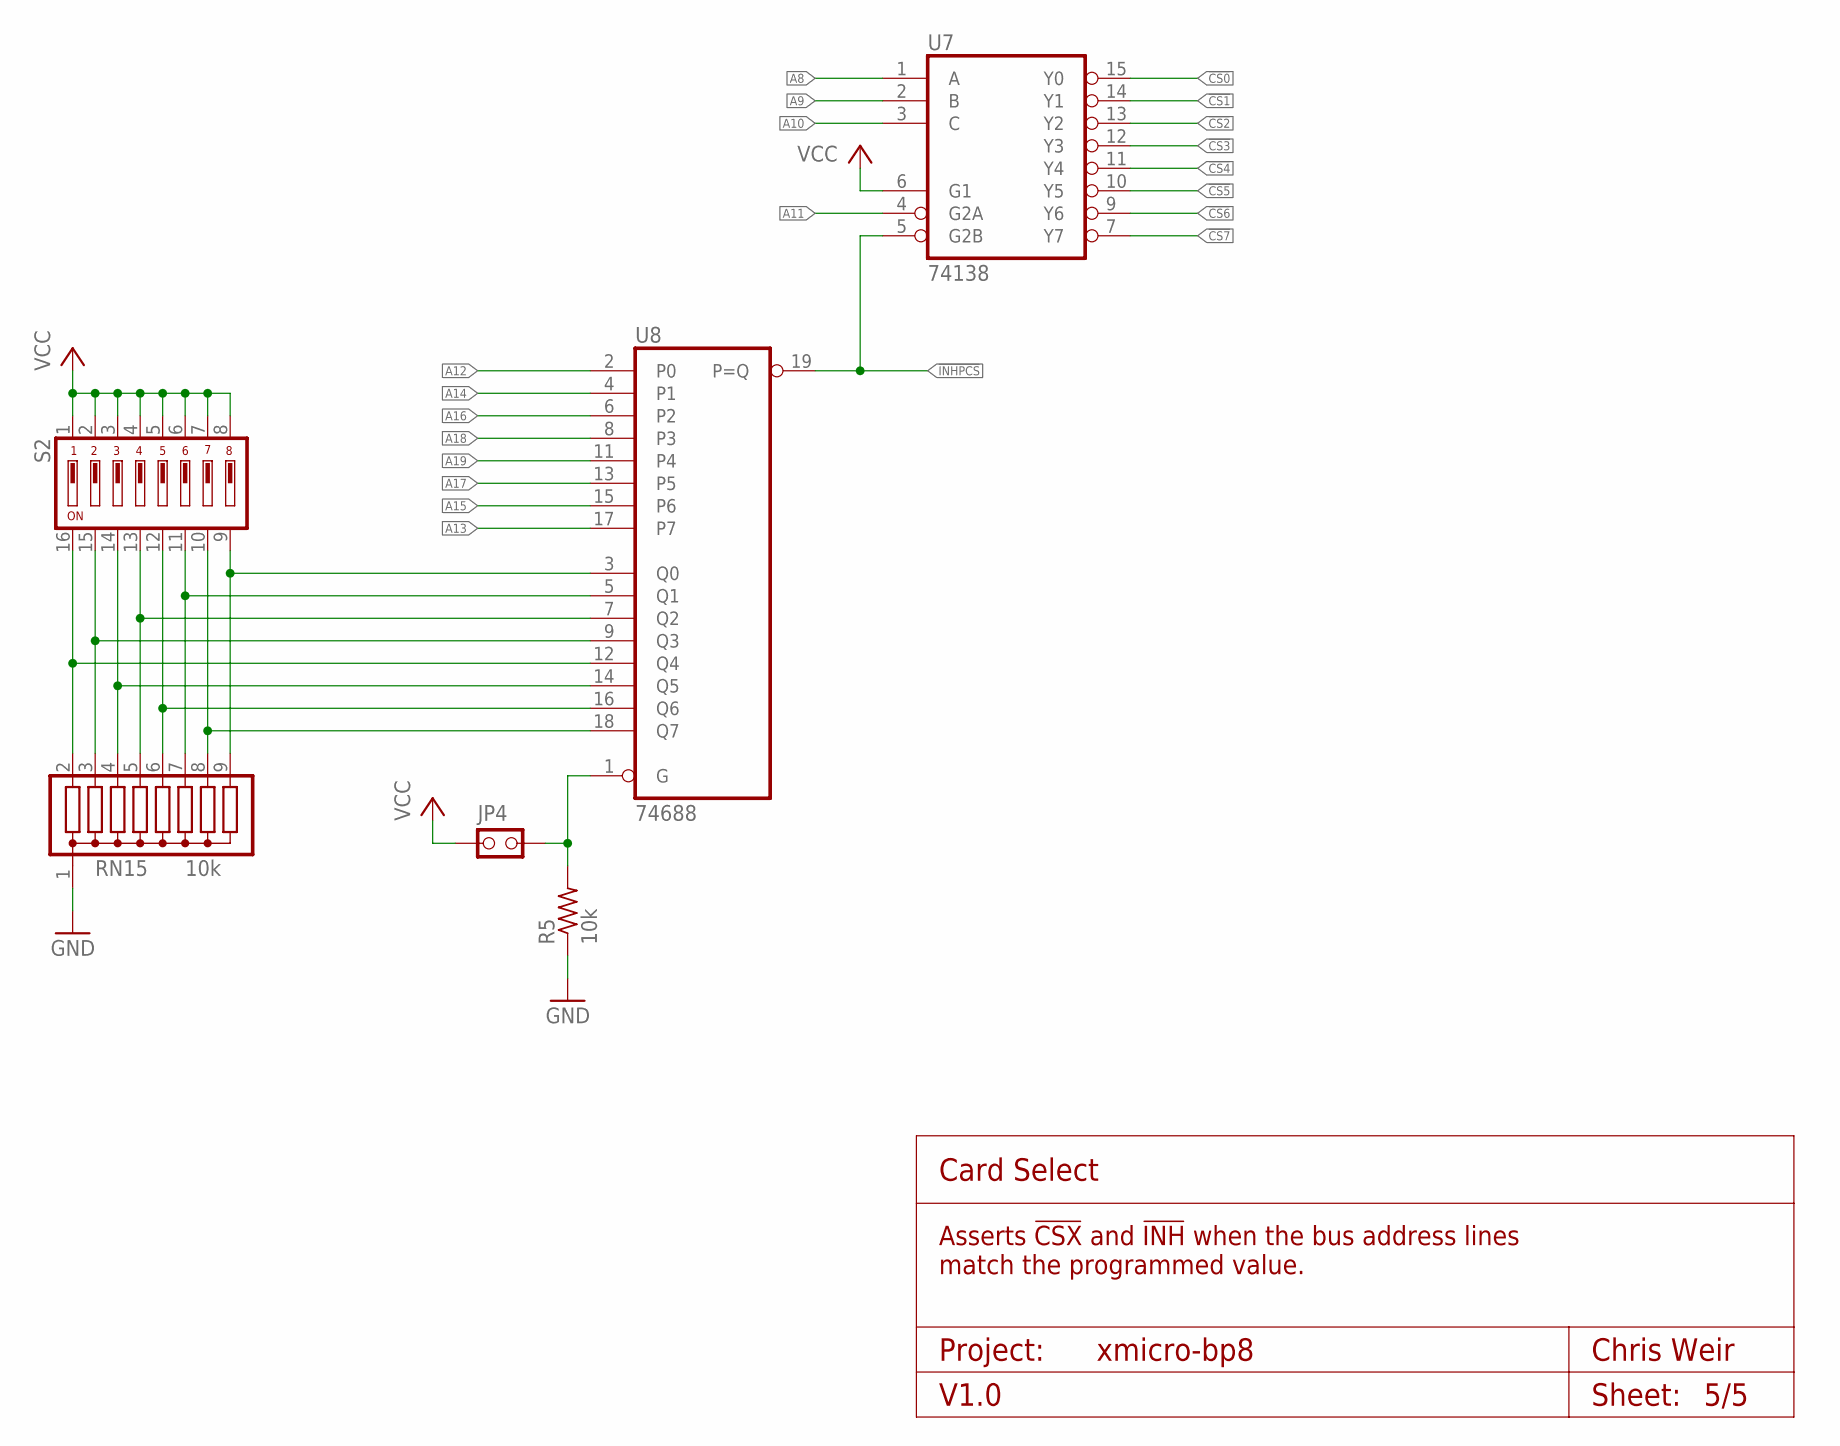
[picture p22: schematic XMICRO-BP8.sch, sheet 5]

Parts:
JP4: PINHD-1X2THRU; 1X02
R5: 10k; 0207/10
RN15: 10k; SIL9
S2: SW-DIP08; SW-DIP8
U7: 74138; DIL16
U8: 74688; DIL20

Connections:
!CS0: U7.15 (Y0)
!CS1: U7.14 (Y1)
!CS2: U7.13 (Y2)
!CS3: U7.12 (Y3)
!CS4: U7.11 (Y4)
!CS5: U7.10 (Y5)
!CS6: U7.9 (Y6)
!CS7: U7.7 (Y7)
!INHPCS: U7.5 (G2B), U8.19 (P=Q)
A8: U7.1 (A)
A9: U7.2 (B)
A10: U7.3 (C)
A11: U7.4 (G2A)
A12: U8.2 (P0)
A13: U8.17 (P7)
A14: U8.4 (P1)
A15: U8.15 (P6)
A16: U8.6 (P2)
A17: U8.13 (P5)
A18: U8.8 (P3)
A19: U8.11 (P4)
GND: R5.1, RN15.1
unnamed: RN15.2, S2.16, U8.12 (Q4)
unnamed: RN15.3, S2.15, U8.9 (Q3)
unnamed: RN15.4, S2.14, U8.14 (Q5)
unnamed: RN15.5, S2.13, U8.7 (Q2)
unnamed: RN15.6, S2.12, U8.16 (Q6)
unnamed: RN15.7, S2.11, U8.5 (Q1)
unnamed: RN15.8, S2.10, U8.18 (Q7)
unnamed: RN15.9, S2.9, U8.3 (Q0)
unnamed: JP4.2, R5.2, U8.1 (G)
VCC: JP4.1, S2.1, S2.2, S2.3, S2.4, S2.5, S2.6, S2.7, S2.8, U7.6 (G1)

Notes on the sheet:
Card Select
Asserts !CSX! and !INH! when the bus address lines match the programmed value.
Project:
V1.0
Chris Weir
Sheet:
