X-Microsystems/xmicro-bp8/(commit log)

2019-05-28 Updated schematic xrefs to indicate signal direction.
    [XMICRO-BP8.brd, XMICRO-BP8.sch]
2024-09-15 Updated to Gen 2 V1.0
    [XMICRO BP8.brd, XMICRO BP8.sch, XMICRO-BP8 BOM.csv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]
2024-09-15 Rearranged document files
    [BOM.csv]
2024-10-01 Reduced per-contact current rating from 3.0A (connector spec) to 2.0A (XMICRO bus spec)
